jackmachiela/WeatherBoard/(commit log)

2023-07-14 Changed logic for LED strip
2023-07-14 Circuit description, rev 3
